bastian2001/erace-cup-receiver/erace-rx-v2/BOM.xlsx

Designator | Footprint | JLCPCB Part #（optional） |  | Comment
AE1 | 1206 | C293767 |  | ANT3216LL00R2400A
AE2 | SMD | C152351 |  | 0479480001 2.4GHz Molex
BN1 | SMD | C318884 |  | TS-1187A-B-A-B
C1,C4,C6,C10 | 0402 | C52923 |  | 1uF
C15 | 0603 | C1623 |  | 470nF
C19,C21 | 0402 | C72135 |  | 1.2pF
C2,C3,C11,C12,C13 | 0402 | C307331 |  | 100 nF
C20,C26,C27 | 0805 | C45783 |  | 22uF
C5,C14,C16 | 0402 | C15195 |  | 10nF
C7,C8 | 0402 | C1547 |  | 12pF
C9 | 0603 | C19702 |  | 10uF
D1 | 0402 | C965794 |  | LED green
D2,D4 | SOD-323 | C191023 |  | 1N5819WS
FL1 | 0402-4P | C6054595 |  | 2.4GHz Filter RF
J1 | SMD,P=1mm | C5340778 |  | 1.0mm-8P-WT
J2 | SMD | C393939 |  | TYPE-C16PIN
L1 | 0402 | C880712 |  | 2.0nH
L2 | 0402 | C19898 |  | 3.0nH
L5 | 0603 | C57838 |  | 15µH
P1,P2,P3,P4 |  |  | do not populate | Solder Pad
Q1,Q2 | SOT-23 | C8545 |  | 2N7002 MOSFET Jiangsu
R1,R2,R3 | 0402 | C25744 |  | 10k
R13 |  |  | do not populate | 0 Ohm
R4,R6 | 0402 | C11702 |  | 1k
R5,R7,R11 | 0402 | C25890 |  | 3.3k
R8,R12 | 0402 | C25105 |  | 33 Ohm
R9,R10 | 0402 | C25905 |  | 5.1k
RF1 | QFN-24-EP(4x4) | C2151551 |  | SX1281IMLTRT
U1 | QFN-32-EP(5x5) | C2858491 |  | ESP32-C3FH4
U2 | SOT-223 | C6186 |  | AMS1117-3.3
Y1 | SMD3225-4P | C331597 |  | 40MHz Crystal
Y2 | SMD3225-4P | C7294606 |  | 52MHz Crystal
D3 | 0402 | C25503345 |  | LED red
