bastian2001/erace-cup-receiver/erace-rx-v2/Exports/schematics.pdf

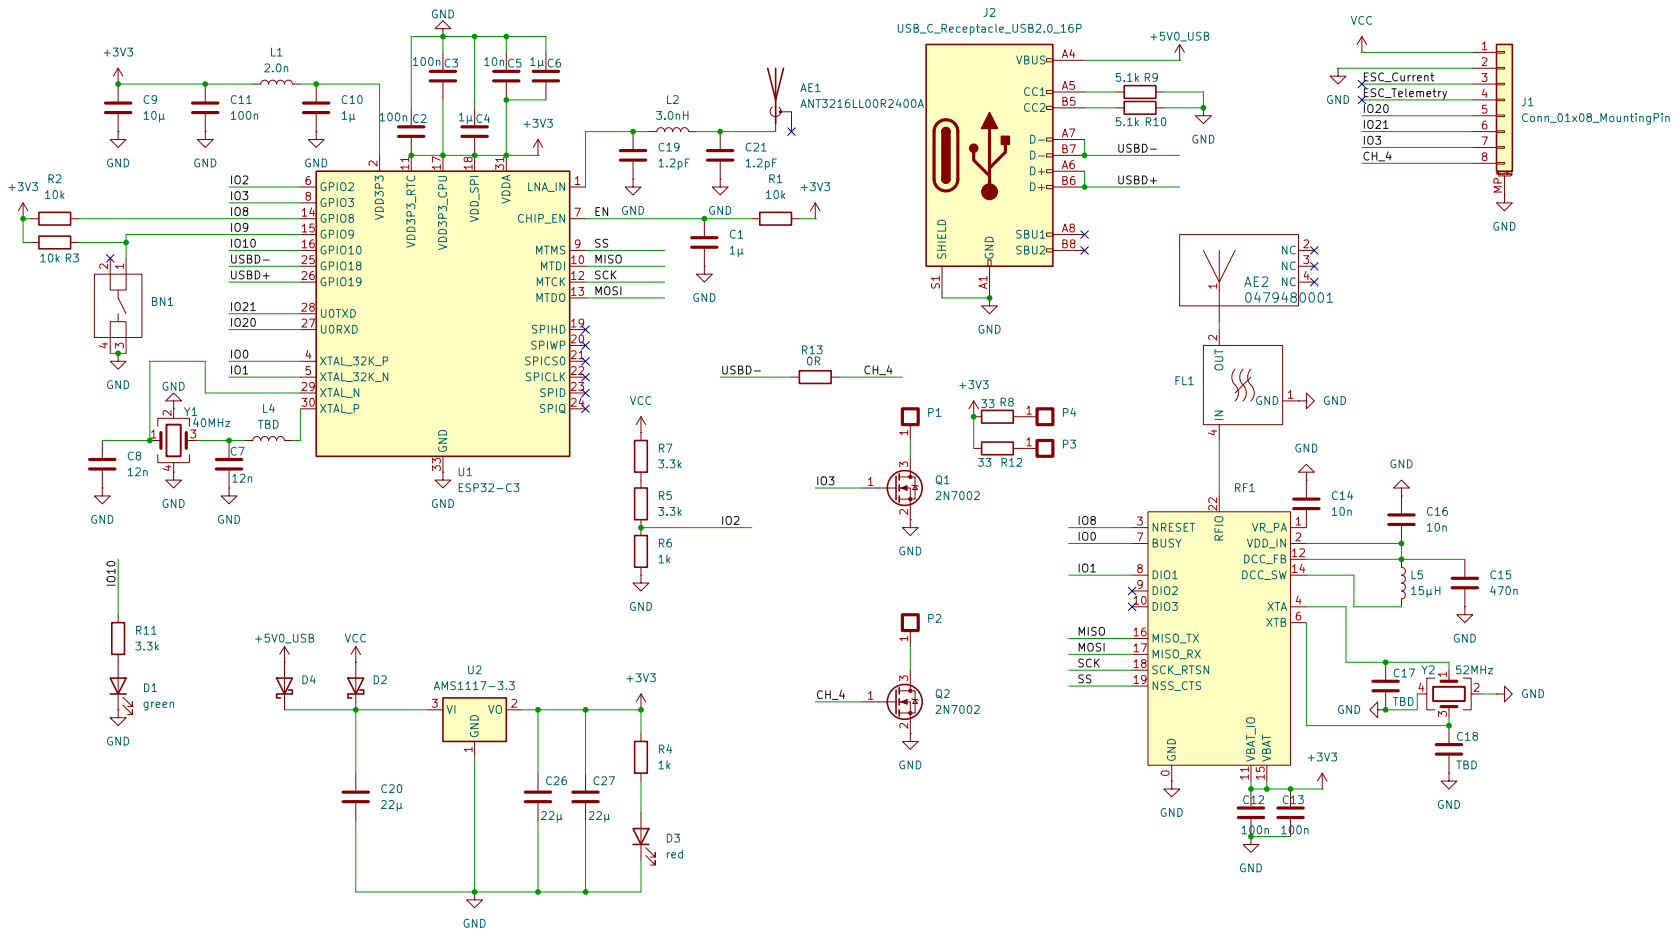
[picture p1: page 1]
