bastian2001/erace-cup-receiver/erace-rx-v2/erace-rx-v2.kicad_pcb

## KiCad design erace-rx-v2/erace-rx-v2.kicad_pcb (2024-11-29)

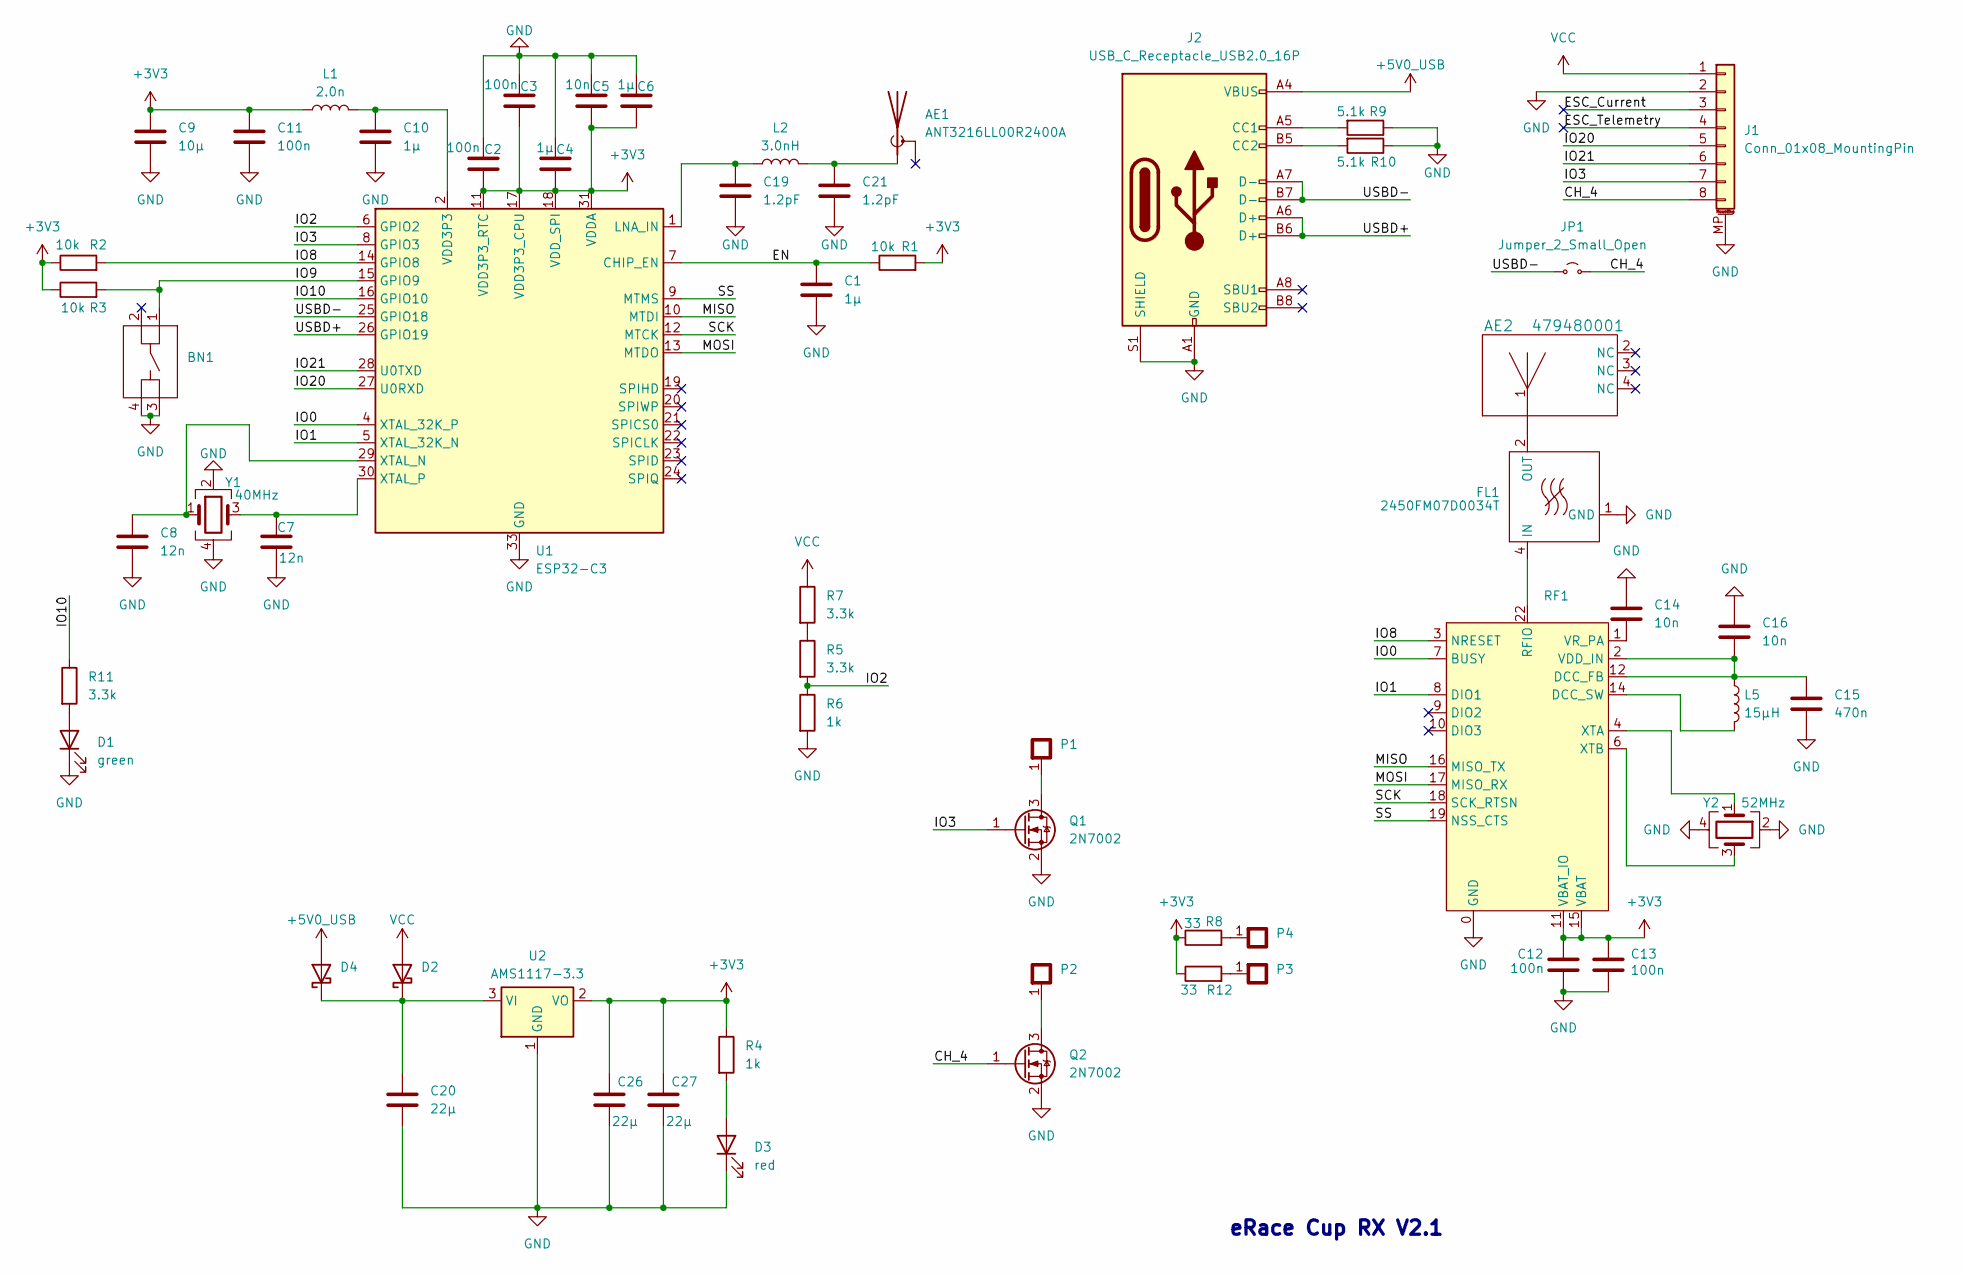
[picture p2: schematic erace-rx-v2.kicad_sch]

Parts:
AE1: ANT3216LL00R2400A; 1206 antenna
AE2: 479480001; ANT_47948-0001_MOL
BN1: button
C1, C4, C6, C10: 1µ; C_0402_1005Metric
C2, C3, C11, C12, C13: 100n; C_0402_1005Metric
C5, C14, C16: 10n; C_0402_1005Metric
C7, C8: 12n; C_0402_1005Metric
C9: 10µ; C_0603_1608Metric
C15: 470n; C_0603_1608Metric
C19, C21: 1.2pF; C_0402_1005Metric
C20, C26, C27: 22µ; C_0805_2012Metric
D1: green; LED_0402_1005Metric
D2, D4: D_Schottky; D_SOD-323
D3: red; LED_0402_1005Metric
FL1: 2450FM07D0034T; 0402 RF Filter
J1: Conn_01x08_MountingPin; JST_SH_SM08B-SRSS-TB_1x08-1MP_P1.00mm_Horizontal
J2: USB_C_Receptacle_USB2.0_16P; USB-C
JP1: Jumper_2_Small_Open; solder bridge
L1: 2.0n; L_0402_1005Metric
L2: 3.0nH; L_0402_1005Metric
L5: 15µH; L_0603_1608Metric
P1, P2, P3, P4: Solder Pad
Q1, Q2: 2N7002; SOT-23
R1, R2, R3: 10k; R_0402_1005Metric
R4, R6: 1k; R_0402_1005Metric
R5, R7, R11: 3.3k; R_0402_1005Metric
R8, R12: 33; R_0402_1005Metric
R9, R10: 5.1k; R_0402_1005Metric
RF1: SX128x
U1: ESP32-C3; QFN-32-1EP_5x5mm_P0.5mm_EP3.7x3.7mm
U2: AMS1117-3.3; SOT-223-3_TabPin2
Y1: 40MHz; Crystal_SMD_3225-4Pin_3.2x2.5mm
Y2: 52MHz; Crystal_SMD_3225-4Pin_3.2x2.5mm

Connections:
+3V3: C2.2, C3.2, C4.2, C5.2, C6.2, C9.1, C11.1, C12.1, C13.1, C26.1, C27.1, L1.1, R1.2, R2.1, R3.1, R4.1, R8.1, R12.1, RF1.11 (VBAT_IO), RF1.15 (VBAT), U1.11 (VDD3P3_RTC), U1.17 (VDD3P3_CPU), U1.18 (VDD_SPI), U1.31 (VDDA), U1.32 (VDDA), U2.2 (VO)
+5V0_USB: D4.2 (A), J2.A4 (VBUS), J2.A9 (VBUS), J2.B4 (VBUS), J2.B9 (VBUS)
/CH_4: J1.8, JP1.2 (B), Q2.1 (G)
/EN: C1.1, R1.1, U1.7 (CHIP_EN)
/ESC_Current: J1.3
/ESC_Telemetry: J1.4
/IO0: RF1.7 (BUSY), U1.4 (XTAL_32K_P)
/IO1: RF1.8 (DIO1), U1.5 (XTAL_32K_N)
/IO2: R5.2, R6.1, U1.6 (GPIO2)
/IO3: J1.7, Q1.1 (G), U1.8 (GPIO3)
/IO8: R2.2, RF1.3 (NRESET), U1.14 (GPIO8)
/IO9: BN1.1, R3.2, U1.15 (GPIO9)
/IO10: R11.1, U1.16 (GPIO10)
/IO20: J1.5, U1.27 (U0RXD)
/IO21: J1.6, U1.28 (U0TXD)
/MISO: RF1.16 (MISO_TX), U1.10 (MTDI)
/MOSI: RF1.17 (MISO_RX), U1.13 (MTDO)
/SCK: RF1.18 (SCK_RTSN), U1.12 (MTCK)
/SS: RF1.19 (NSS_CTS), U1.9 (MTMS)
/USBD+: J2.A6 (D+), J2.B6 (D+), U1.26 (GPIO19)
/USBD-: J2.A7 (D-), J2.B7 (D-), JP1.1 (A), U1.25 (GPIO18)
GND: BN1.3, BN1.4, C1.2, C2.1, C3.1, C4.1, C5.1, C6.1, C7.2, C8.2, C9.2, C10.2, C11.2, C12.2, C13.2, C14.1, C15.2, C16.1, C19.1, C20.2, C21.2, C26.2, C27.2, D1.1 (K), D3.1 (K), FL1.1 (GND), FL1.3 (GND), J1.2, J1.MP (MountPin), J2.A1 (GND), J2.A12 (GND), J2.B1 (GND), J2.B12 (GND), J2.S1 (SHIELD), Q1.2 (S), Q2.2 (S), R6.2, R9.1, R10.1, RF1.0 (GND), RF1.5 (GND), RF1.13 (GND), RF1.20 (GND), RF1.21 (GND), RF1.23 (GND), RF1.24 (GND), U1.33 (GND), U2.1 (GND), Y1.2, Y1.4, Y2.2, Y2.4
unnamed: AE1.1 (A), C21.1, L2.2
unnamed: D1.2 (A), R11.2
unnamed: C20.1, D2.1 (K), D4.1 (K), U2.3 (VI)
unnamed: D3.2 (A), R4.2
unnamed: FL1.4 (IN), RF1.22 (RFIO)
unnamed: AE2.1, FL1.2 (OUT)
unnamed: J2.A5 (CC1), R9.2
unnamed: J2.B5 (CC2), R10.2
unnamed: P3.1, R12.2
unnamed: P4.1, R8.2
unnamed: P1.1, Q1.3 (D)
unnamed: P2.1, Q2.3 (D)
unnamed: R5.1, R7.2
unnamed: C15.1, C16.2, L5.1, RF1.2 (VDD_IN), RF1.12 (DCC_FB)
unnamed: L5.2, RF1.14 (DCC_SW)
unnamed: C14.2, RF1.1 (VR_PA)
unnamed: RF1.4 (XTA), Y2.1
unnamed: RF1.6 (XTB), Y2.3
unnamed: C19.2, L2.1, U1.1 (LNA_IN)
unnamed: C8.1, U1.29 (XTAL_N), Y1.1
unnamed: C7.1, U1.30 (XTAL_P), Y1.3
VCC: D2.2 (A), J1.1, R7.1
VDD3P3: C10.1, L1.2, U1.2 (VDD3P3), U1.3 (VDD3P3)

Notes on the sheet:
eRace Cup RX V2.1

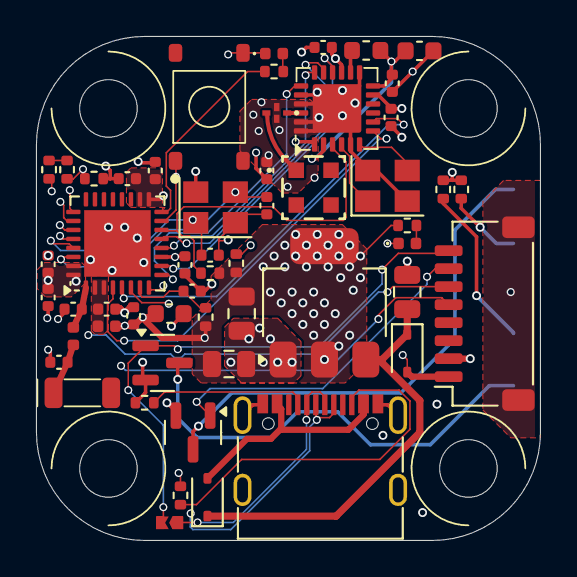
[picture p3: board erace-rx-v2.kicad_pcb from above]

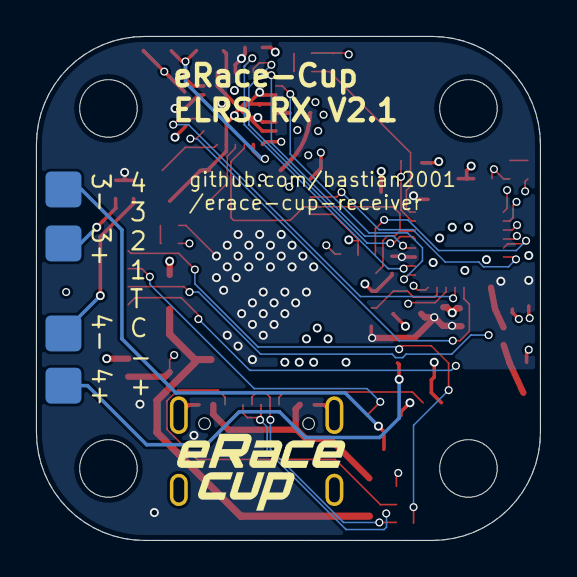
[picture p4: board erace-rx-v2.kicad_pcb from below]

Board: 4 copper layers, 28.0 x 28.0 mm, 58 parts (4 on the bottom side), 43 nets.
