bastian2001/erace-cup-receiver/(commit log)

2024-07-09 started first version
    [erace-rx-v1.kicad_pcb, erace-rx-v1.kicad_sch]
2024-07-10 move one folder up
    [erace-rx-v1.kicad_pcb, erace-rx-v1.kicad_sch]
2024-07-10 v2 layout
    [erace-rx-v2.kicad_pcb, erace-rx-v2.kicad_sch]
2024-07-12 0 DRC violations :tada:
    [erace-rx-v1.kicad_pcb, erace-rx-v1.kicad_sch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]
2024-07-13 corrected XTAL, updated for JLC stock
    [BOM.xlsx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]
2024-08-12 adjusted for Johanson filter, moved power LED
    [erace-rx-v2.kicad_pcb, erace-rx-v2.kicad_sch]
2024-11-29 V2.1 as ordered
    [BOM.xlsx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]
